Sridd20/terrain-aware-rover/comparative_study.png

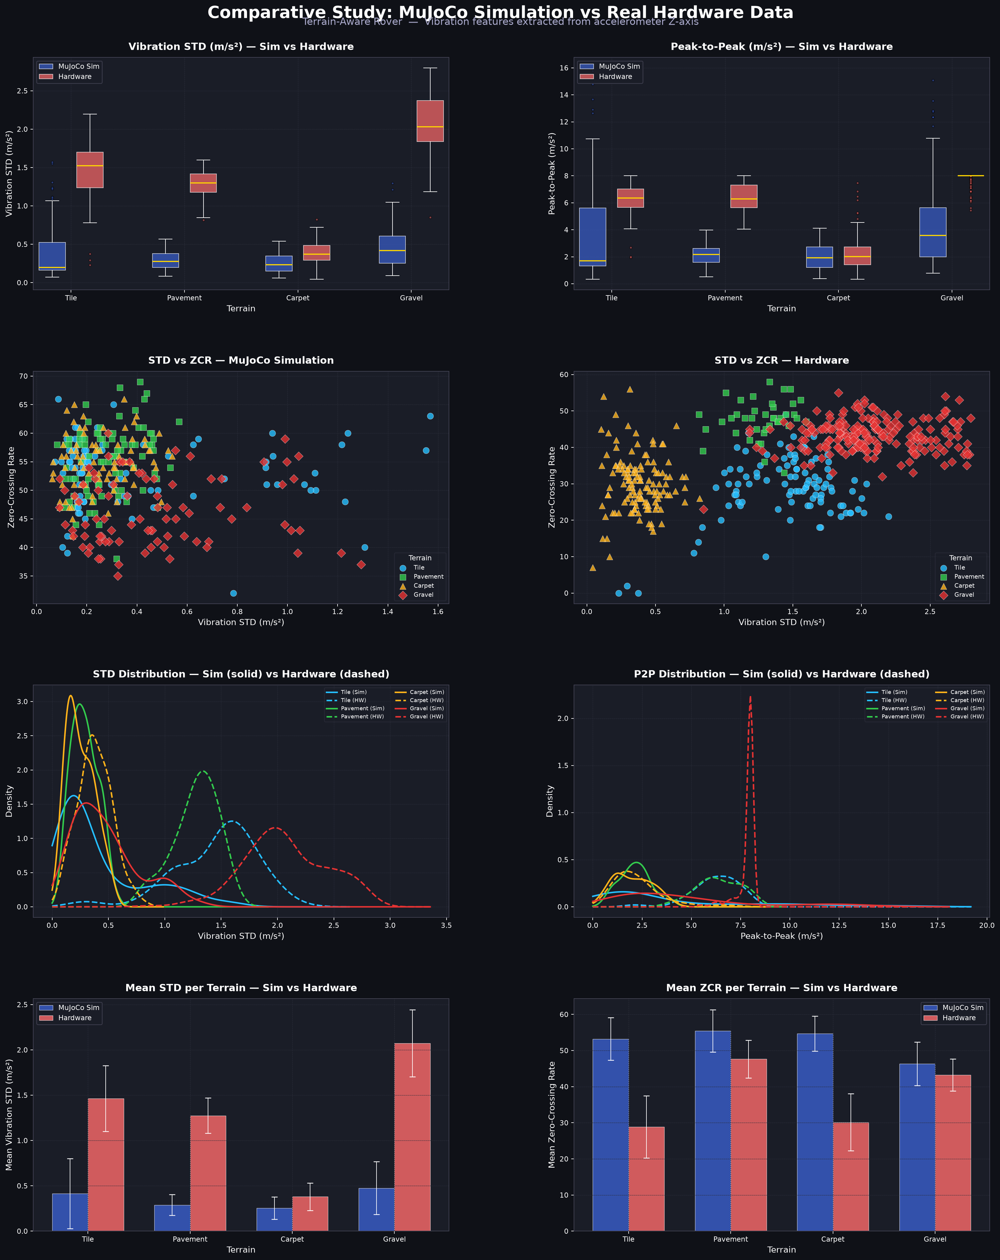
comparative_study.png
