Sridd20/terrain-aware-rover/dataset_summary_table.png

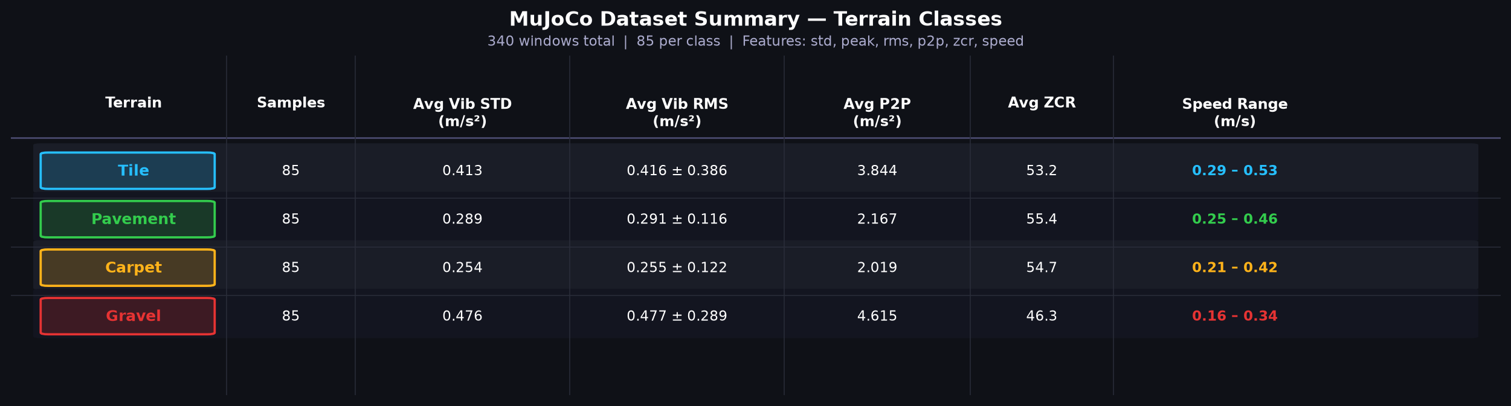
dataset_summary_table.png
