Sridd20/terrain-aware-rover/dataset_summary_table_hw.png

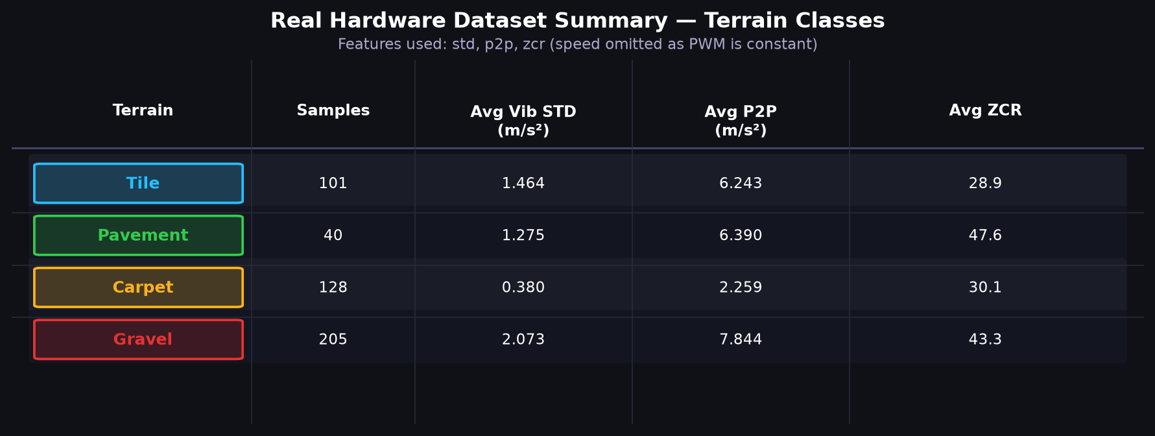
dataset_summary_table_hw.png
