Sridd20/terrain-aware-rover/example_plots.png

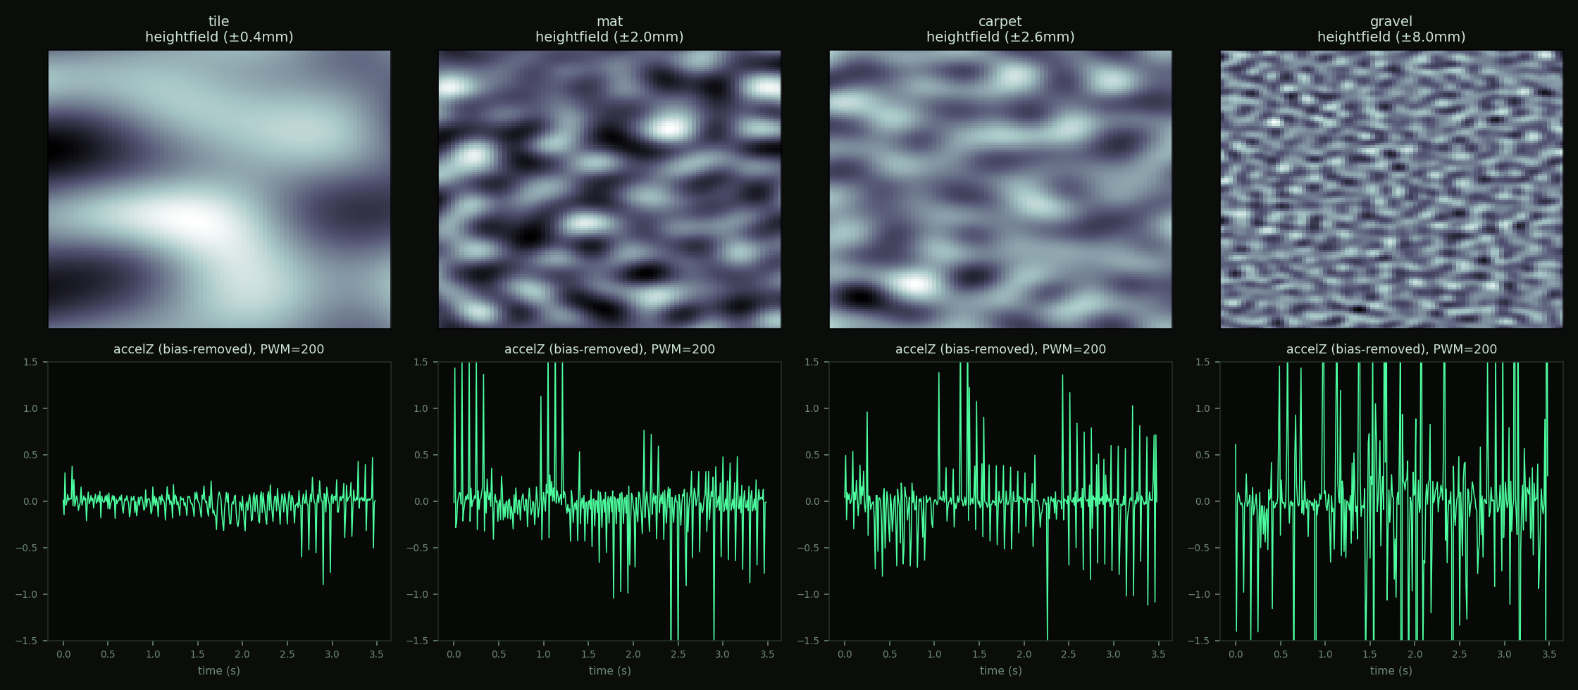
example_plots.png
