Sridd20/terrain-aware-rover/scatter_speed_vib.png

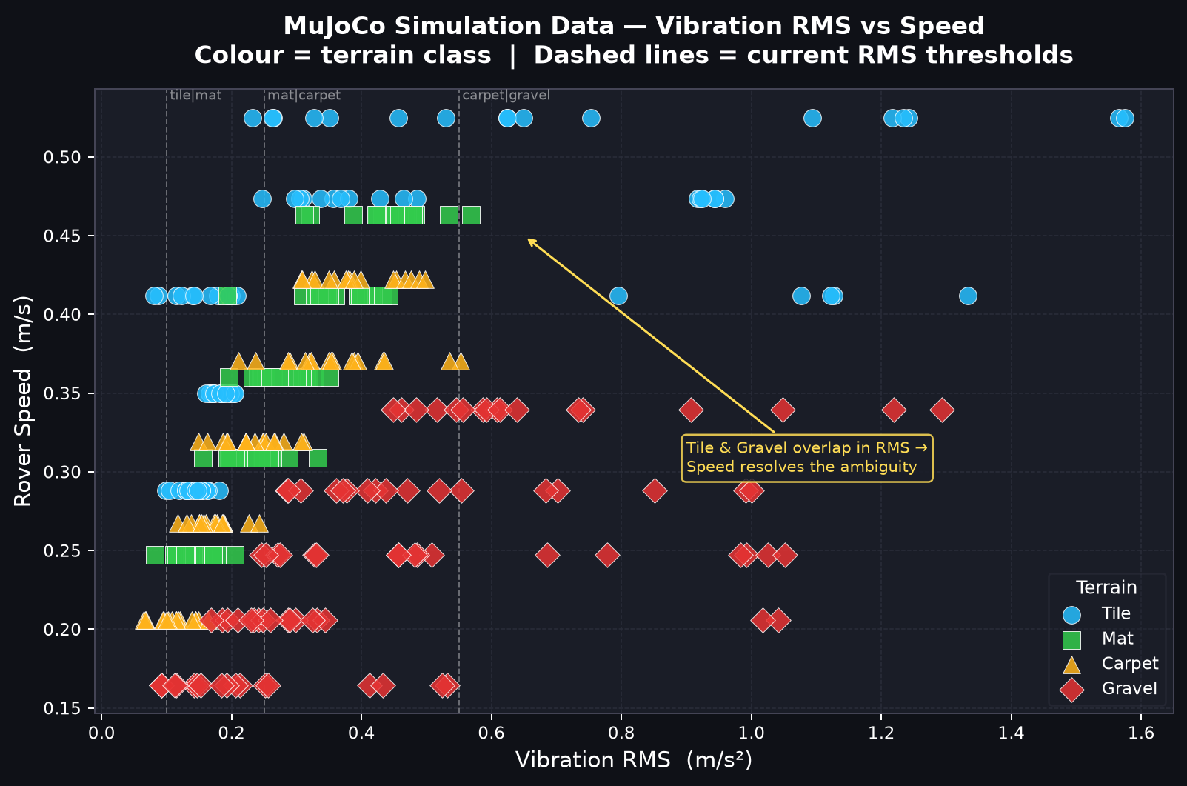
scatter_speed_vib.png
