Sridd20/terrain-aware-rover/scatter_speed_vibb.png

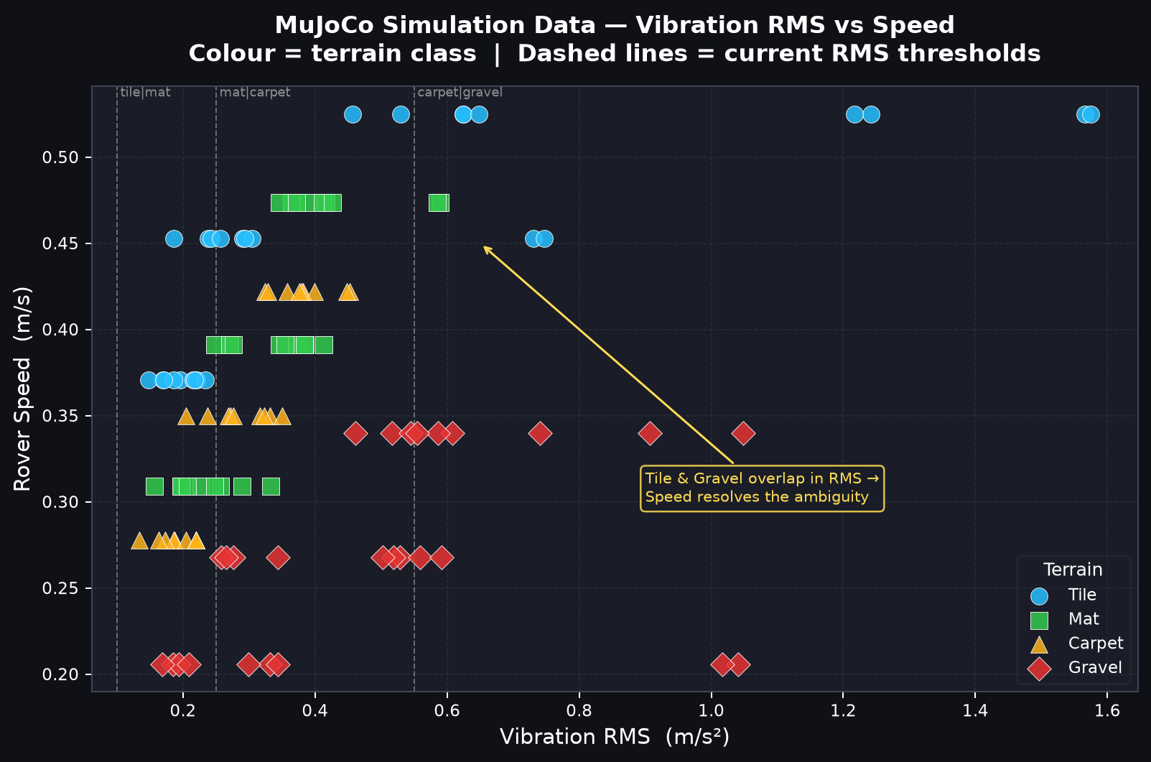
scatter_speed_vibb.png
