Sridd20/terrain-aware-rover/scatter_std_zcr.png

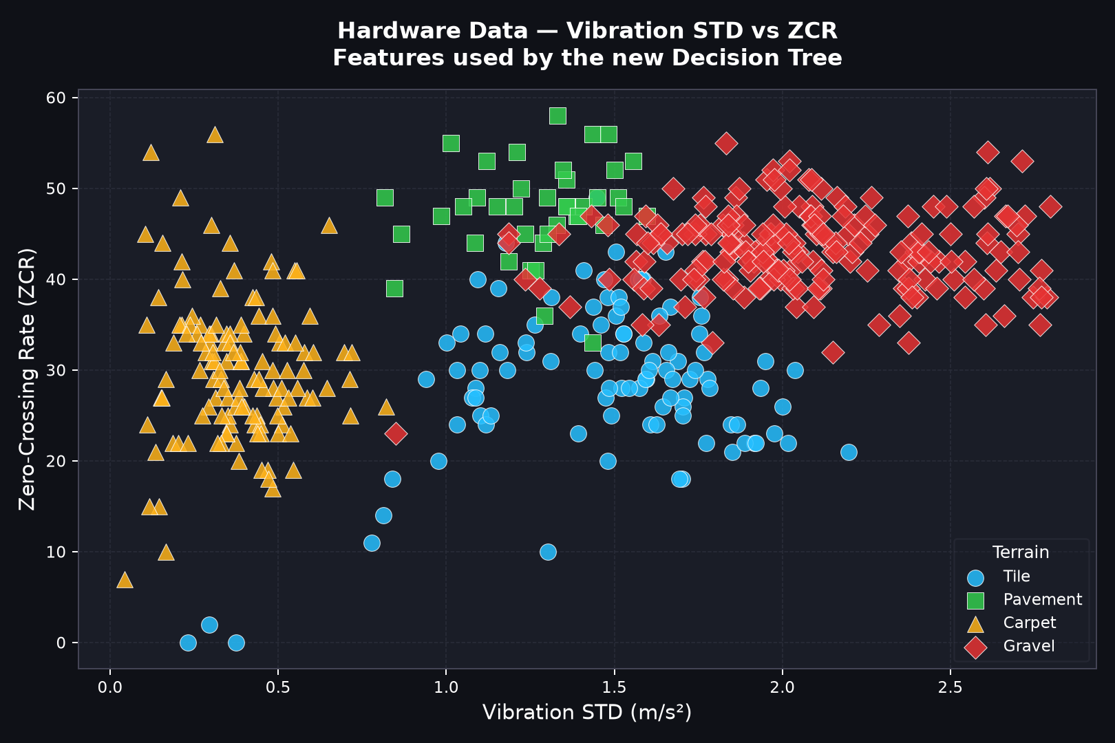
scatter_std_zcr.png
