Sridd20/terrain-aware-rover/ml_results.txt

Loaded 4 files, 592 rows (label map applied: {})
label
gravel      212
tile        163
carpet      155
pavement     62 

Run IDs: guessed from timestamp gaps (add a 'session' column to the logger for real session-wise splits)
label
carpet      15
gravel      10
pavement     2
tile         3 

Cleaning: dropped 24 idle + 94 repeated windows (592 -> 474)
label
gravel      205
carpet      128
tile        101
pavement     40 

WARNING: ['pavement'] have < 3 runs - validated with 10-window blocks, not whole runs. Their scores are upper bounds.

Not used (see FIRMWARE_FEATURES comment): ['rms']
'speed' is constant (single PWM) - excluded; collect more PWM levels to use it
Features used: ['std', 'p2p', 'zcr'] 

=== Decision Tree (leave-one-run-out: accuracy 0.903, macro-F1 0.867) ===
              precision    recall  f1-score   support

      carpet      0.992     0.992     0.992       128
      gravel      0.914     0.932     0.923       205
    pavement      0.660     0.825     0.733        40
        tile      0.885     0.762     0.819       101

    accuracy                          0.903       474
   macro avg      0.863     0.878     0.867       474
weighted avg      0.907     0.903     0.903       474

Confusion matrix (rows=true, cols=predicted):
          carpet  gravel  pavement  tile
carpet       127       1         0     0
gravel         0     191         9     5
pavement       0       2        33     5
tile           1      15         8    77 

=== KNN (leave-one-run-out: accuracy 0.869, macro-F1 0.828) ===
              precision    recall  f1-score   support

      carpet      0.932     0.961     0.946       128
      gravel      0.876     0.927     0.900       205
    pavement      0.700     0.700     0.700        40
        tile      0.835     0.703     0.763       101

    accuracy                          0.869       474
   macro avg      0.836     0.823     0.828       474
weighted avg      0.867     0.869     0.867       474

Confusion matrix (rows=true, cols=predicted):
          carpet  gravel  pavement  tile
carpet       123       0         1     4
gravel         0     190         7     8
pavement       1       9        28     2
tile           8      18         4    71 

=== Random Forest (leave-one-run-out: accuracy 0.903, macro-F1 0.871) ===
              precision    recall  f1-score   support

      carpet      0.969     0.992     0.981       128
      gravel      0.936     0.922     0.929       205
    pavement      0.744     0.800     0.771        40
        tile      0.816     0.792     0.804       101

    accuracy                          0.903       474
   macro avg      0.866     0.877     0.871       474
weighted avg      0.903     0.903     0.903       474

Confusion matrix (rows=true, cols=predicted):
          carpet  gravel  pavement  tile
carpet       127       0         0     1
gravel         0     189         5    11
pavement       0       2        32     6
tile           4      11         6    80 

Simplest model within 2% of best macro-F1: Decision Tree

Final decision tree (trained on all cleaned data):
|--- std <= 0.75
|   |--- zcr <= 4.50
|   |   |--- class: 3
|   |--- zcr >  4.50
|   |   |--- class: 0
|--- std >  0.75
|   |--- p2p <= 7.54
|   |   |--- zcr <= 40.50
|   |   |   |--- zcr <= 38.50
|   |   |   |   |--- std <= 0.89
|   |   |   |   |   |--- class: 3
|   |   |   |   |--- std >  0.89
|   |   |   |   |   |--- class: 3
|   |   |   |--- zcr >  38.50
|   |   |   |   |--- p2p <= 6.14
|   |   |   |   |   |--- class: 3
|   |   |   |   |--- p2p >  6.14
|   |   |   |   |   |--- class: 1
|   |   |--- zcr >  40.50
|   |   |   |--- std <= 1.60
|   |   |   |   |--- zcr <= 46.00
|   |   |   |   |   |--- class: 2
|   |   |   |   |--- zcr >  46.00
|   |   |   |   |   |--- class: 2
|   |   |   |--- std >  1.60
|   |   |   |   |--- p2p <= 7.07
|   |   |   |   |   |--- class: 1
|   |   |   |   |--- p2p >  7.07
|   |   |   |   |   |--- class: 1
|   |--- p2p >  7.54
|   |   |--- zcr <= 31.00
|   |   |   |--- class: 3
|   |   |--- zcr >  31.00
|   |   |   |--- std <= 1.56
|   |   |   |   |--- p2p <= 7.78
|   |   |   |   |   |--- class: 1
|   |   |   |   |--- p2p >  7.78
|   |   |   |   |   |--- class: 2
|   |   |   |--- std >  1.56
|   |   |   |   |--- class: 1

Wrote rover_firmware/terrain_classifier.h via built-in exporter (micromlgen not installed); classes {0: 'carpet', 1: 'gravel', 2: 'pavement', 3: 'tile'}
