Sridd20/terrain-aware-rover/(commit log)

2026-09-02 Initial commit: terrain-aware rover - IMU classifer and traction control
    [dataset.csv]
2026-09-09 feat: adaptive blind terrain controller + mixed random track
    - Add build_mixed_terrain_model(): stitches N terrain segments in random
    order along the X axis with a 3-column cosine cross-fade at boundaries
    - Add AdaptiveController: reads IMU Z-axis RMS every 50ms, low-pass
    smooths (alpha=0.20), classifies terrain blindly via RMS thresholds,
    and applies matching target speed + motor kv from ADAPTIVE_POLICY.
    Includes 250-step settle delay to ignore the initial drop-spike.
    - Add view_mixed_terrain(): infinite-looping viewer, teleports rover
    back to start at far end, prints live terrain/RMS/speed to terminal
    - New CLI flags: --view-adaptive, --seed, --segments
    - Fix: replace Unicode arr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
    [terrain_sim.py]
2026-09-09 feat: color-code rover chassis by detected terrain label
    TERRAIN_COLORS maps tile/mat/carpet/gravel to cyan/green/amber/red.
    - view_mixed_terrain: chassis color updates live whenever label changes
    - view_terrain: chassis color set once (fixed terrain)
    Color only changes on label transition (no per-frame rgba writes)
    [terrain_sim.py]
2026-09-09 feat: color-code terrain surfaces using separate hfield geoms
    Replace single grey heightfield with N separate hfield assets (one per
    segment), each with its own MJCF material and TERRAIN_COLOR rgba:
    tile -> cyan-blue (0.15, 0.75, 1.00)
    mat -> green (0.20, 0.80, 0.30)
    carpet -> amber (1.00, 0.70, 0.10)
    gravel -> red (0.90, 0.20, 0.20)
    Adds MJCF_MULTI_TERRAIN template with {seg_assets}/{seg_geoms} slots.
    Uses model.hfield_adr[i] to write each segment into the correct offset
    in model.hfield_data. Removes chassis coloring (surface is the indicator).
    [terrain_sim.py]
2026-09-09 fix: rover stuck at seams — normalize all hfields to shared max_elev
    Each segment was normalized independently to [0,1] then scaled by its
    own elev_m, causing height discontinuities of up to 8mm at boundaries.
    Fix: blend heights in metre space, then normalise by max_elev (shared
    across all segments). All hfield assets now declare max_elev in size=.
    Rover can now cross segment transitions without getting trapped.
    [terrain_sim.py]
2026-09-09 fix: rover not moving forward (wheels locked)
    The AdaptiveController was incorrectly setting biasprm[1] (which controls
    position spring stiffness) instead of biasprm[2] (which controls velocity
    damping) for the MuJoCo velocity actuators. This caused the wheels to
    act as tight springs trying to stay at angle 0, preventing forward motion
    and causing the jittering. Fixed by writing to biasprm[2].
    [terrain_sim.py]
2026-09-09 feat: add WASD manual driving mode
    - Adds ManualController mapped to WASD (W: forward, S: reverse/stop,
    A: turn left, D: turn right, Space: stop).
    - Hooks into mujoco.viewer.launch_passive via key_callback.
    - Adds --view-wasd CLI flag to launch mixed terrain with manual control.
    [terrain_sim.py]
2026-09-09 Add ML classifier pipeline: richer dataset, scatter plot, summary table
    - generate_ml_dataset.py: 5 PWM levels per terrain, 10s rollouts, speed as explicit feature -> ml_dataset.csv (340 windows, 85/class)
    - plot_scatter.py: Vibration RMS vs Speed scatter plot from MuJoCo data, shows RMS threshold failure
    - plot_dataset_summary.py: styled dataset summary table for presentation
    - README: document ML pipeline, RMS threshold failure, new scripts and figures
    [ml_dataset.csv]
2026-09-12 Add MuJoCo terrain sim, dataset summary, ML plan, and scatter plot
    [dataset_summary.csv]
2026-09-25 feat: rover firmware update and dashboard update
    [ml_dataset_fresh.csv]
2026-09-27 fix: right motor dead due to GPIO25 ADC2/WiFi conflict
    GPIO 25 (IN3, right motor direction A) is ADC2_CH8 on ESP32.
    WiFi.softAP() uses ADC2 internally for RF calibration, which
    silently reconfigures ADC2 pins as analog inputs, breaking
    digitalWrite. This caused the right motor to never spin while
    WiFi was active, even though the motor and L298N were fine.
    Fix: re-assert pinMode(OUTPUT) for PIN_IN3/PIN_IN4 inside
    setRightMotor() on every call to reclaim the pin from ADC2.
    Also:
    - Switch motor PWM from analogWrite to ledcWrite with explicit
    ledcAttachChannel (channels 4 and 5) to lock LEDC assignments
    before WiFi starts, preventing channel conflicts
    - Fix ENB pin: GPIO 13 (was wrongly do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
    [rover_firmware.ino]
2026-10-07 rename terrain label: mat -> pavement across all project files
    [dataset.csv, dataset_summary.csv, ml_dataset.csv, ml_dataset_fresh.csv]
2026-10-08 fix: add peak feature, bump IMU to +-8g, remove buck converter refs, update README
    [collect_data.py, mujoco_to_firmware.py, rover_firmware.ino, terrain_classifier.h]
2026-10-08 Train classifier on final 4-class data and export header
    [carpet_train_dataset.csv, gravel_train_dataset.csv, pavement_train_datase.csv, tile_train_dataset.csv]
